turbo-gecko/PS2KBTool/Fritzing/PS2KB Tool_schem.png

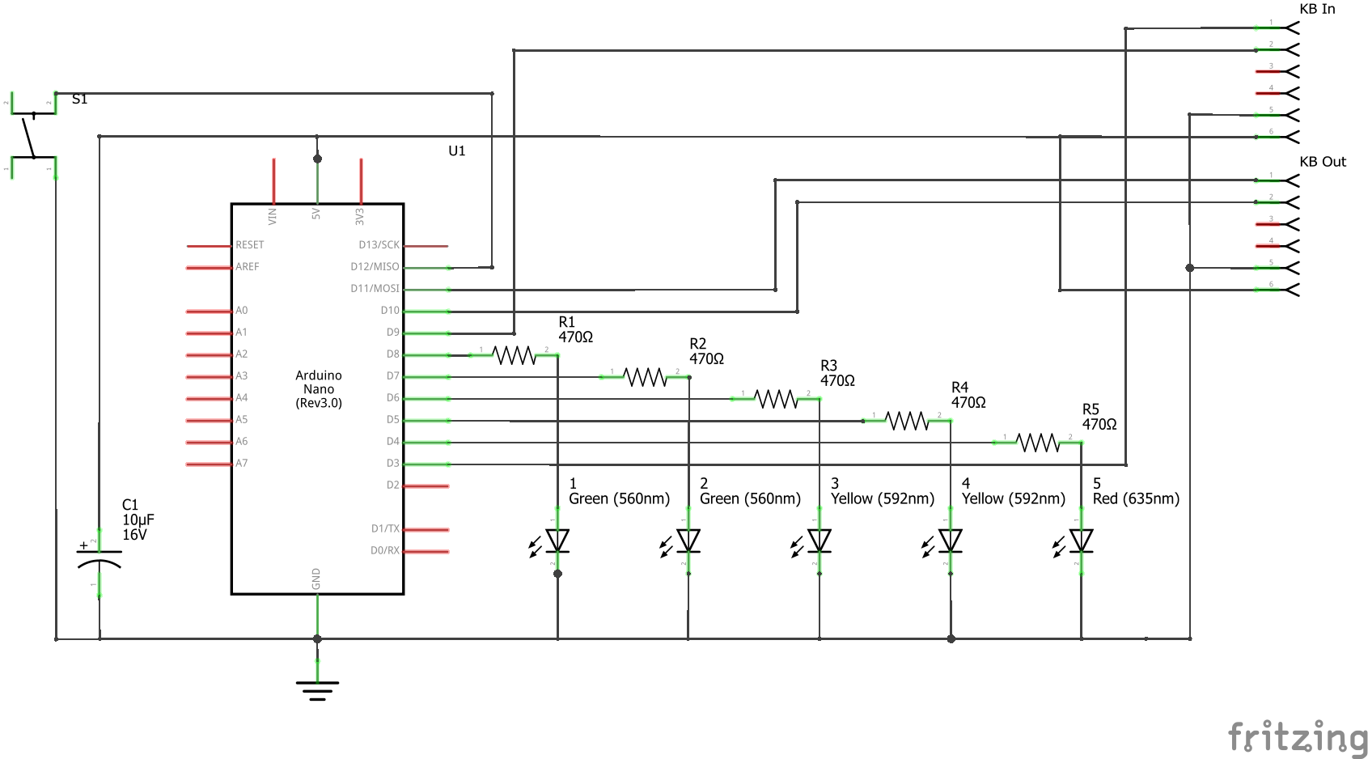
Fritzing/PS2KB Tool_schem.png
