turbo-gecko/PS2KBTool/v1 Hardware/Developer Edition Schematic v1.pdf

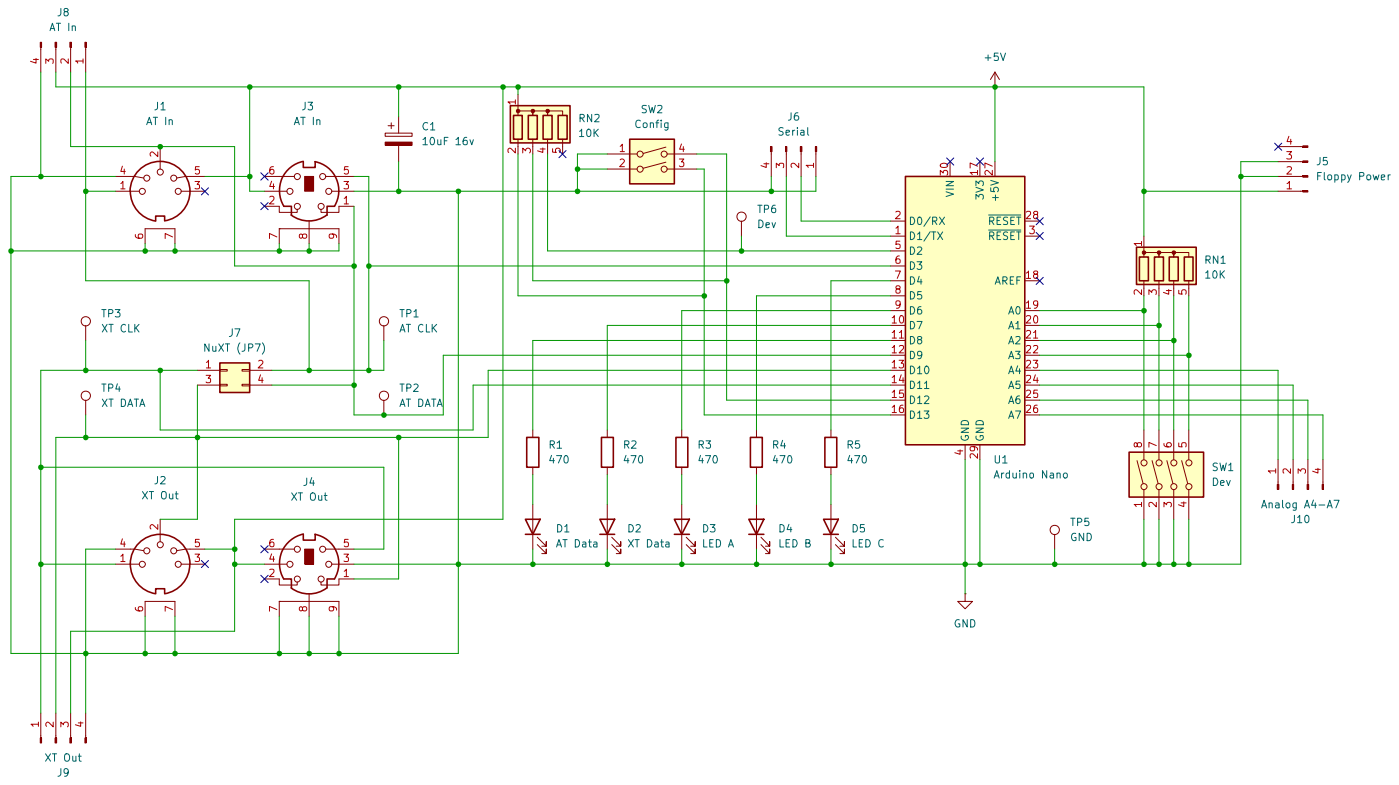
[picture p4: page 1]
