turbo-gecko/PS2KBTool/v1 Hardware/Standard Mini Edition v1.pdf

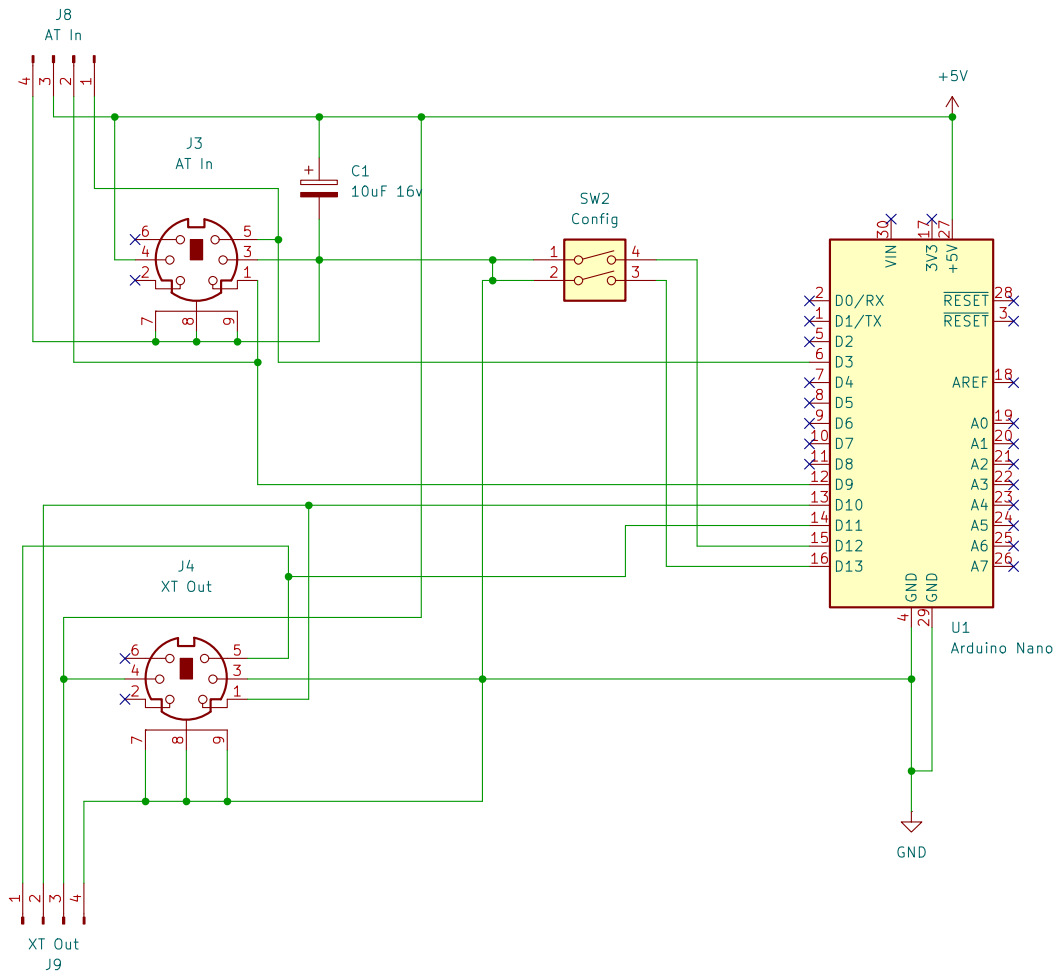
[picture p5: page 1]
