turbo-gecko/PS2KBTool/keyboard.cpp

/*
 * keyboard.cpp
 * 
 * Keyboard scan code helper functions.
 * 
 * This software is copyright 2024-2025 by Gary Hammond (ZL3GH). It is free
 * to use for non-commercial purposes.
 * 
 * WARNING: DO NOT USE this software in any medical device or for any 
 * other mission critical purpose.
 * 
 * Use of this software could result in a universe ending paradox so 
 * use entirely at your own risk. No warranties or guarantees are 
 * expressed or implied.
 */

#include <Arduino.h>
#include <EEPROM.h>

#include "globals.h"

#include "eeprom_utils.h"

static bool ext_keys_enabled     = false;
static unsigned int board_type   = 1;

static unsigned int i;

struct key_code
{
  byte key;
  byte xt_code;
  byte at_code;
};

// Standard non-extended key codes
static const struct key_code key_table[] =
{
  {1, 0x29, 0x0E},
  {2, 0x02, 0x16},
  {3, 0x03, 0x1E},
  {4, 0x04, 0x26},
  {5, 0x05, 0x25},
  {6, 0x06, 0x2E},
  {7, 0x07, 0x36},
  {8, 0x08, 0x3D},
  {9, 0x09, 0x3E},
  {10, 0x0A, 0x46},
  {11, 0x0B, 0x45},
  {12, 0x0C, 0x4E},
  {13, 0x0D, 0x55},
  {15, 0x0E, 0x66},
  {16, 0x0F, 0x0D},
  {17, 0x10, 0x15},
  {18, 0x11, 0x1D},
  {19, 0x12, 0x24},
  {20, 0x13, 0x2D},
  {21, 0x14, 0x2C},
  {22, 0x15, 0x35},
  {23, 0x16, 0x3C},
  {24, 0x17, 0x43},
  {25, 0x18, 0x44},
  {26, 0x19, 0x4D},
  {27, 0x1A, 0x54},
  {28, 0x1B, 0x5B},
  {29, 0x2B, 0x5D},
  {30, 0x3A, 0x58},
  {31, 0x1E, 0x1C},
  {32, 0x1F, 0x1B},
  {33, 0x20, 0x23},
  {34, 0x21, 0x2B},
  {35, 0x22, 0x34},
  {36, 0x23, 0x33},
  {37, 0x24, 0x3B},
  {38, 0x25, 0x42},
  {39, 0x26, 0x4B},
  {40, 0x27, 0x4C},
  {41, 0x28, 0x52},
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
};

// Extended (pre-fixed with '0xEO) single byte key codes (Not 101+ extra navigation keys)
static const struct key_code key_table_ext[] =
{
  {59, 0x5B, 0x1F},   // Win
  {62, 0x38, 0x11},   // Right Alt
  {63, 0x5C, 0x27},   // Context Menu
  {64, 0x1D, 0x14},   // Right Shift
  {65, 0x5D, 0x2F},   // Alt Graphics
  {0, 0x00, 0x00}
};

// Extended (pre-fixed with '0xEO) single byte key codes 101+ extra navigation keys
static const struct key_code key_table_ext_nav[] =
{
  {0, 0xF0, 0xF0},    // key up
  {75, 0x52, 0x70},   // Insert
  {76, 0x53, 0x71},   // Delete
  {79, 0x4B, 0x6B},   // Left Arrow
  {80, 0x47, 0x6C},   // Home
  {81, 0x4F, 0x69},   // End
  {83, 0x48, 0x75},   // Up Arrow
  {84, 0x50, 0x72},   // Down Arrow
  {85, 0x49, 0x7D},   // Page Up
  {86, 0x51, 0x7A},   // Page Down
  {89, 0x4D, 0x74},   // Right Arrow
  {95, 0x35, 0x4A},   // Numpad /
  {100, 0x37, 0x7C},  // Numpad * and Print Screen
  {108, 0x1C, 0x5A},  // Numpad Enter
  {0, 0x00, 0x00}
};

// Extended (pre-fixed with '0xEO) single byte key codes to have the 0xE0 stripped
static const struct key_code key_table_ext_strip[] =
{
  {95, 0x35, 0x4A},   // Numpad /
  {108, 0x1C, 0x5A},  // Numpad Enter
  {0, 0x00, 0x00}
};

//*************************************************************************
byte AT2XT(byte scan_code)
{
  static byte xt_code;
  xt_code = 0;

  for(i = 0; i < sizeof(key_table); i++)
  {
    if (key_table[i].at_code == scan_code)
    {
      xt_code = key_table[i].xt_code;
      break;
    }
  }
  return xt_code;
}

//*************************************************************************
byte AT2XTExt(byte scan_code)
{
  static byte xt_code;
  xt_code = 0;

  for(i = 0; i < sizeof(key_table_ext); i++)
  {
    if (key_table_ext[i].at_code == scan_code)
    {
      xt_code = key_table_ext[i].xt_code;
      break;
    }
  }
  return xt_code;
}

//*************************************************************************
byte AT2XTExtNav(byte scan_code)
{
  static byte xt_code;
  xt_code = 0;

  for(i = 0; i < sizeof(key_table_ext_nav); i++)
  {
    if (key_table_ext_nav[i].at_code == scan_code)
    {
      xt_code = key_table_ext_nav[i].xt_code;
      break;
    }
  }
  return xt_code;
}

//*************************************************************************
byte AT2XTExtStrip(byte scan_code)
{
  for(i = 0; i < sizeof(key_table_ext_strip); i++)
  {
    if (key_table_ext_strip[i].at_code == scan_code)
    {
      return key_table_ext_strip[i].xt_code;
    }
  }
  return 0;
}

//*************************************************************************
void kBoardType(const unsigned int value)
{
  EEPROM.get(E_BOARD_TYPE, board_type);
  if (board_type != value)
  {
    if ((value > 0) & (value < B_LAST))
    {
      board_type = value;
      EEPROM.put(E_BOARD_TYPE, value);
      eUpdateCrc();
    }
  }
}

//*************************************************************************
unsigned int kGetBoardType()
{
  EEPROM.get(E_BOARD_TYPE, board_type);
  return board_type;
}

//*************************************************************************
void kDelayTimings(byte value, byte item)
{
  switch(item)
  {
    case 1:
      EEPROM.put(E_AT_BIT_DELAY, value);
      break;
    case 2:
      EEPROM.put(E_AT_NEXT_DELAY, value);
      break;
    case 3:
      EEPROM.put(E_AT_START_DELAY, value);
      break;
    case 4:
      EEPROM.put(E_XT_BIT_DELAY, value);
      break;
    case 5:
      EEPROM.put(E_XT_NEXT_DELAY, value);
      break;
    case 6:
      EEPROM.put(E_XT_START_DELAY, value);
      break;
    default:
      break;
  }
  eUpdateCrc();
}

//*************************************************************************
byte kGetDelayTimings(byte item)
{
  byte value = 0;

  switch(item)
  {
    case 1:
      EEPROM.get(E_AT_BIT_DELAY, value);
      break;
    case 2:
      EEPROM.get(E_AT_NEXT_DELAY, value);
      break;
    case 3:
      EEPROM.get(E_AT_START_DELAY, value);
      break;
    case 4:
      EEPROM.get(E_XT_BIT_DELAY, value);
      break;
    case 5:
      EEPROM.get(E_XT_NEXT_DELAY, value);
      break;
    case 6:
      EEPROM.get(E_XT_START_DELAY, value);
      break;
    default:
      break;
  }
  return value;
}

//*************************************************************************
void k101Enabled(const bool value)
{
  if (value)
  {
    ext_keys_enabled = 1;
  }
  else
  {
    ext_keys_enabled = 0;
  }
  EEPROM.put(E_EXT_KEYS_ENABLED, ext_keys_enabled);
  eUpdateCrc();
}

//*************************************************************************
bool kGet101Enabled()
{
  EEPROM.get(E_EXT_KEYS_ENABLED, ext_keys_enabled);
  if (ext_keys_enabled == 0)
  {
    return false;
  }
  else
  {
    return true;
  }
}
