turbo-gecko/PS2KBTool/(commit log)

2024-12-31 v0.03.00 First working version
    Only the Pause/Break key is not registering.
    Lights are not working...ToDo.
    [PS2KBTool.ino, globals.h, nano_def.h]
2025-01-01 v0.04.00 Non-extended mode
    Non extended mode is nearly there.
    Still no LED's.
2025-01-01 v0.04.01 Serial enable fixes
    Several tidy ups.
    [PS2KBTool.ino, globals.h, nano_def.h, serial_utils.cpp]
2025-01-24 Interim commit
    Fixed issues with EEPROM not being initialised correctly at first load.
    Added support for the new dev board.
    [PS2KBTool.ino, commands.cpp, eeprom_utils.cpp, nano_def.h]
2025-02-01 Interim commit
    Added support for keyboard timing delays to be stored in EEPROM.
    Removed board type #IFDEFS.
2025-02-01 Interim commit
    Fixed up spurious XT scan codes from Sysreq and Break keys
    [PS2KBTool.ino]
2025-02-02 Fix for BB version
    [PS2KBTool.ino]
2025-02-02 Added v1 Schematics
